ankur-kumar22/Automatic-Sprinkler-system-/(commit log)

2026-11-03 Test codes for all the components & sensors
    Added test sketches for plant watering project, including ADC diagnostics, moisture sensor tests, relay control, and integration with Blynk.
2026-11-03 Add README for the project
    Added detailed documentation for the Automatic Plant Watering System project, including features, hardware requirements, wiring instructions, safety guidelines, and troubleshooting steps.
