ankur-kumar22/Automatic-Sprinkler-system-/project-setup.jpg

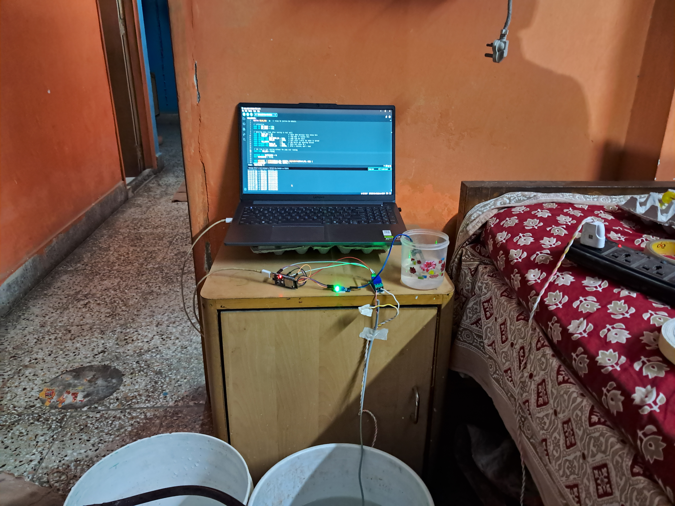
[picture p1: project-setup.jpg]
project-setup.jpg
