ankur-kumar22/Automatic-Sprinkler-system-/project-setup-closeup.jpg

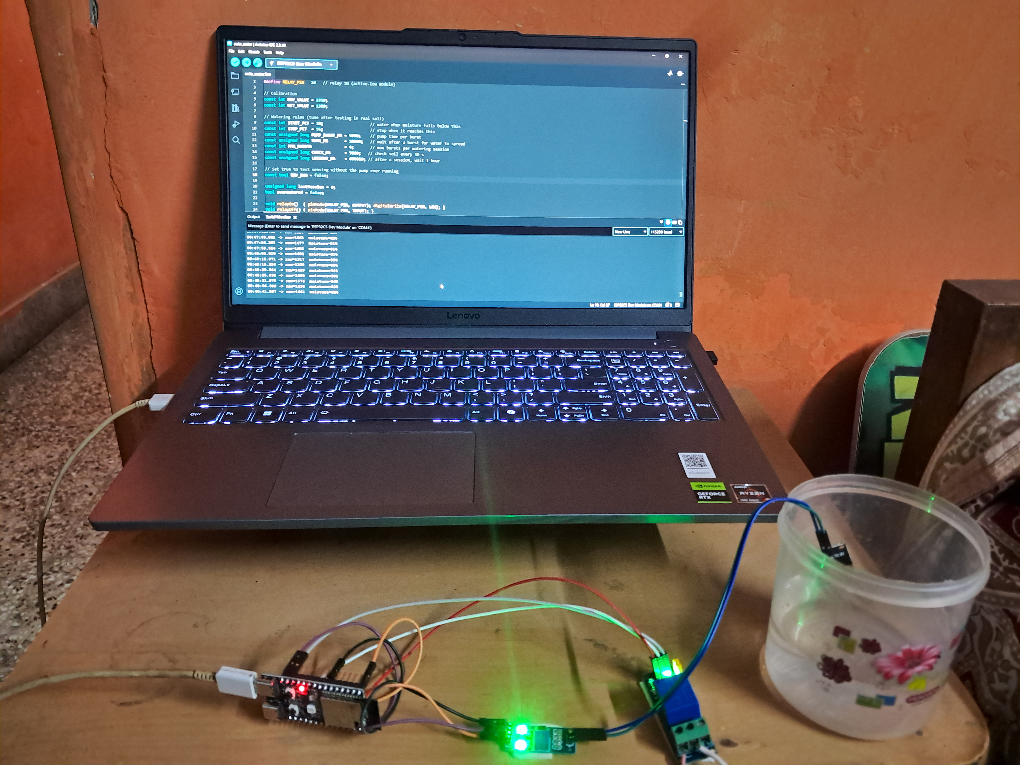
[picture p2: project-setup-closeup.jpg]
project-setup-closeup.jpg
